jongmal/picanvas/docs/bom/edp-board.png

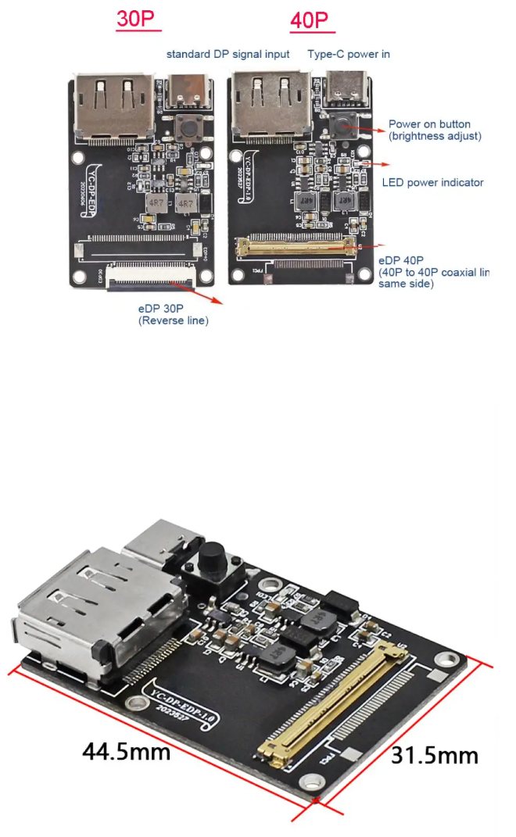
docs/bom/edp-board.png
