jongmal/picanvas/docs/bom/스태퍼모터보드.png

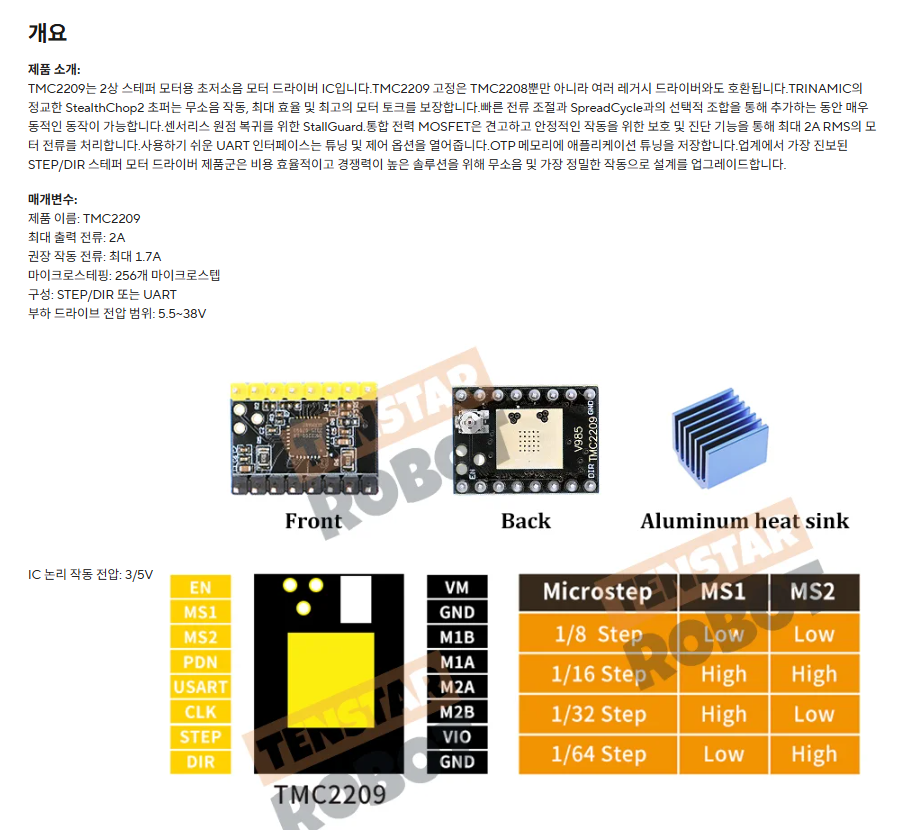
docs/bom/스태퍼모터보드.png
