jongmal/picanvas/docs/진행상황.md

# PiCanvas - 프로젝트 컨텍스트

## 프로젝트 개요
15.6인치 IPS 디스플레이를 사용하는 **벽걸이 회전형 디지털 액자**.
Raspberry Pi 4B 기반으로 가로/세로 90° 자동 회전, API 디지털액자 기능, SD카드 메타데이터 표시 예정.

## 현재 진행 상태 (2026-04-02)

### 완료
- [x] 설계 명세서 작성 (`SPEC.md`)
- [x] 모델 A - 중앙 브라켓 + GT2 80T 풀리 (`src/model_a_center_bracket.scad`)
- [x] 모델 A - 십자 보강재 (`src/model_a_cross_brace.scad`)
- [x] 모델 A - 액자 프레임 6분할 + 도브테일 (`src/model_a_frame.scad`)
- [x] 모델 B - 벽면 브라켓 + 모터 마운트 (`src/model_b_wall_bracket.scad`)
- [x] 전체 어셈블리 (`src/assembly.scad`)
- [x] 플레이트 12개 분리 (`plates/`)
- [x] 180mm 배드 크기 검증 (모두 통과)

### 미완료
- [ ] 부품 마운트 상세 (Pi 4B, eDP 보드, TMC2209, 스텝다운, 디코이, 콘덴서, 퓨즈)
- [ ] LCD 후면 클립 (코드는 있으나 프레임에 미배치)
- [ ] 프레임↔십자 보강재 도브테일 끼워맞춤 검증
- [ ] 벨트 경로 간섭 확인
- [ ] C타입 케이블 진입부 (프레임 하단) 모델링
- [ ] STL 출력 및 실물 테스트핏
- [ ] 소프트웨어 (API 액자, SD 메타데이터 표시)

## 핵심 설계 결정

### 1. Z축 적층 구조 (벽면 → 전면)
```
벽면 → 모델B(5mm) → 턴테이블 고정판(10.5mm) → 회전판 → 모델A 중앙브라켓(5mm) + 80T풀리(8mm) → 십자 보강 → 부품 → LCD(3.2mm) → 베젤 립(3mm)
```
- 턴테이블과 풀리가 같은 평면에서 겹치는 문제 → **Z축 오프셋으로 해결**
- 턴테이블이 하중 담당, 풀리가 회전력 전달

### 2. 프레임 분할
- 원래 4분할 → 가로 181.33mm로 180mm 초과
- **6분할(3x2)로 변경** → 각 세그먼트 120.89 x 114.13mm
- 각 분할선에 도브테일 조인트

### 3. 80T 풀리 일체형
- GT2 80T 외치 풀리가 중앙 브라켓에 일체 성형
- 축 없이 턴테이블 회전판에 직접 체결
- 피치 직경 ~50.93mm, 벨트 폭 6mm + 상하 가이드 플랜지

### 4. 벨트 300mm 폐루프
- 축간 거리 ~98mm (20T↔80T)
- 감속비 4:1, 유효 토크 ~48 N·cm

### 5. 모터 배치
- 17HS4023 팬케이크 모터, 축 수직 (샤프트 위 방향)
- 모델 B에서 측면 클램프로 고정
- 높이 최소화 목적

## 파일 구조
```
picanvas/
├── SPEC.md                    # 설계 명세서 (부품 스펙, 배선도, 회전 메커니즘)
├── docs/
│   ├── CONTEXT.md             # 이 파일 (프로젝트 컨텍스트)
│   ├── bom/                   # 부품 참고 이미지
│   └── modeling/              # 모델링 참고 이미지
├── src/                       # 소스 모델
│   ├── assembly.scad          # 전체 어셈블리 (디버그 뷰)
│   ├── model_a_center_bracket.scad
│   ├── model_a_cross_brace.scad
│   ├── model_a_frame.scad
│   └── model_b_wall_bracket.scad
├── plates/                    # 개별 출력용 (A1 Mini 180mm)
│   ├── plate_1  ~ plate_5     # 중앙 브라켓 + 십자 보강재
│   ├── plate_6  ~ plate_11    # 프레임 6분할
│   └── plate_12               # 모델 B 벽면 브라켓
└── preview/                   # 렌더링 미리보기 PNG
```

## 주요 파라미터 (공통값)
| 파라미터 | 값 | 사용처 |
|---|-----|---|
| lcd_w / lcd_h / lcd_d | 350.66 / 216.25 / 3.2 mm | 전체 |
| frame_wall | 6 mm | 프레임 벽 두께 |
| frame_bezel | 3 mm | 전면 오버랩 |
| bracket_size | 70 mm | 중앙 브라켓 한 변 |
| bracket_thickness | 5 mm | 브라켓/보강재 두께 |
| dt_width / dt_depth | 15 / 8 mm | 도브테일 (브라켓↔보강재) |
| sdt_width / sdt_depth | 10 / 4 mm | 도브테일 (프레임 세그먼트간) |
| tb_size | 57 mm | 턴테이블 베어링 |
| belt_center_distance | 98 mm | 풀리 축간 거리 |

## 배선 요약
```
65W USB-C → PD 디코이(12V) → A: 5V스텝다운→Pi / B: 12V→TMC2209→모터 / C: 12V→eDP보드
Pi GPIO → TMC2209(STEP/DIR) → 모터
Pi micro HDMI → eDP 컨트롤러 → eDP 40pin → 15.6" IPS
```

## OpenSCAD CLI 참고
```bash
# 프리뷰 렌더링
"/c/Program Files/OpenSCAD/openscad.com" -o output.png --imgsize=800,600 --camera=0,0,10,55,0,25,180 input.scad

# STL 출력
"/c/Program Files/OpenSCAD/openscad.com" -o output.stl input.scad
```

## 다음 작업 우선순위
1. 부품 마운트 상세 설계 (Pi, 보드류 고정 방식)
2. LCD 클립 프레임 배치
3. 케이블 진입부 모델링
4. STL 출력 → 테스트핏
5. 소프트웨어 개발 (별도 레포 또는 서브폴더)
