jongmal/picanvas/docs/modeling/openscad_by_claude2.png

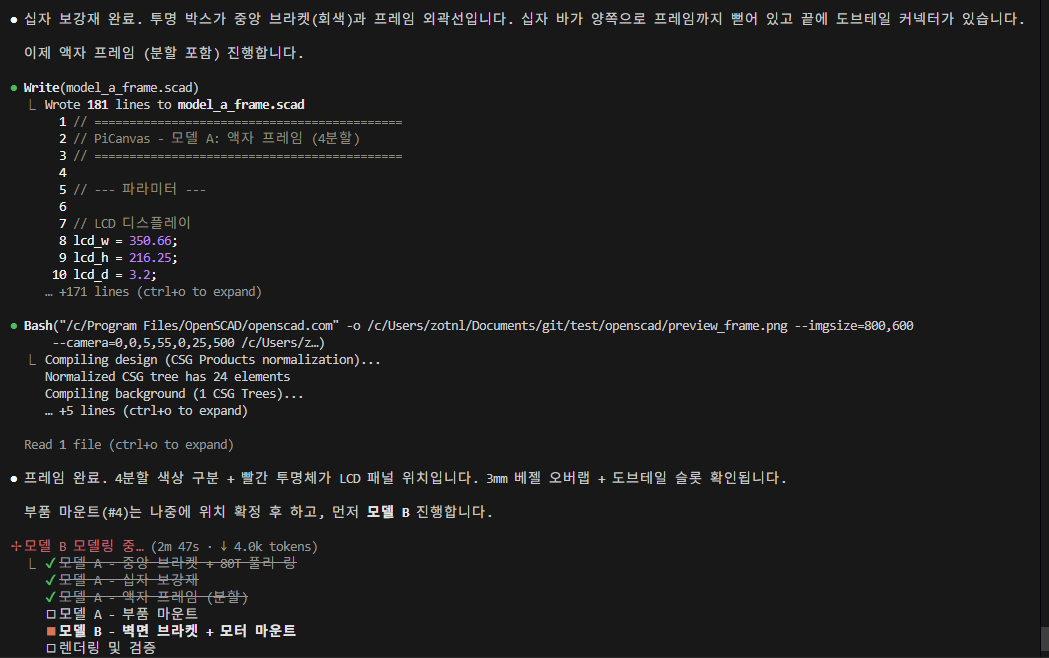
docs/modeling/openscad_by_claude2.png
