jongmal/picanvas/docs/modeling/openscad_by_claude.png

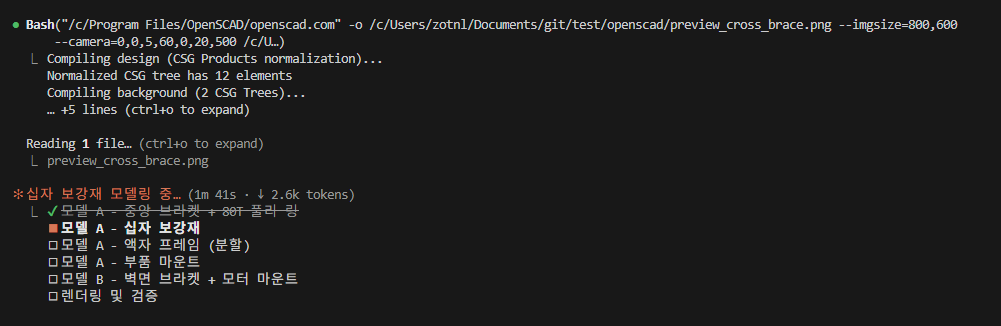
docs/modeling/openscad_by_claude.png
