jongmal/picanvas/preview/preview_center_bracket.png

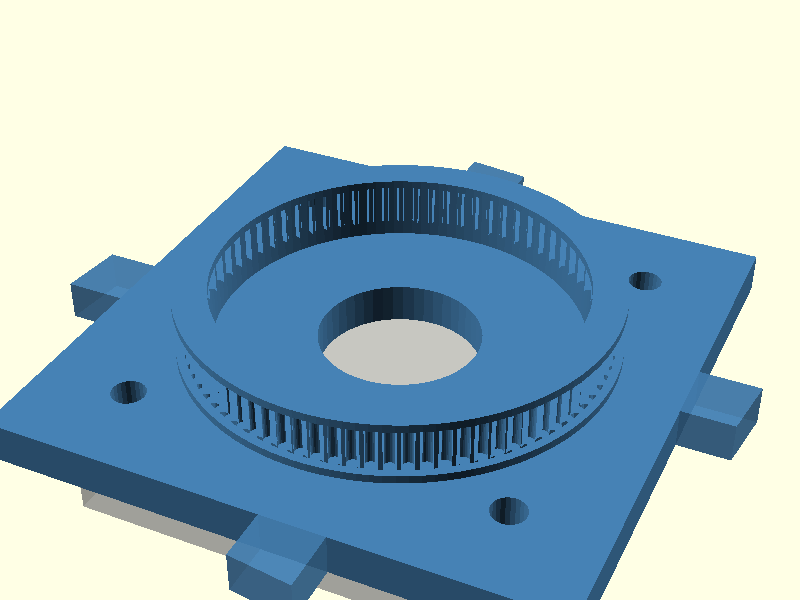
preview/preview_center_bracket.png
