jongmal/picanvas/preview/preview_cross_brace.png

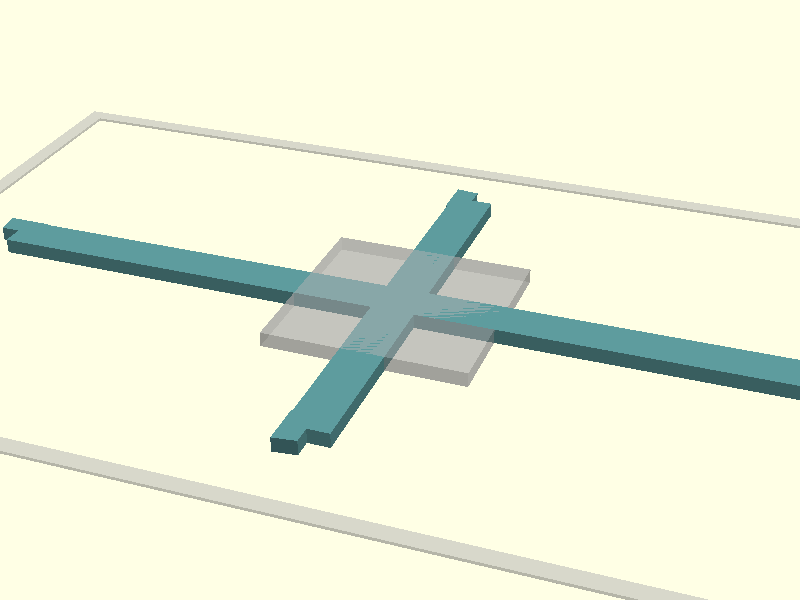
preview/preview_cross_brace.png
