jongmal/picanvas/preview/preview_frame.png

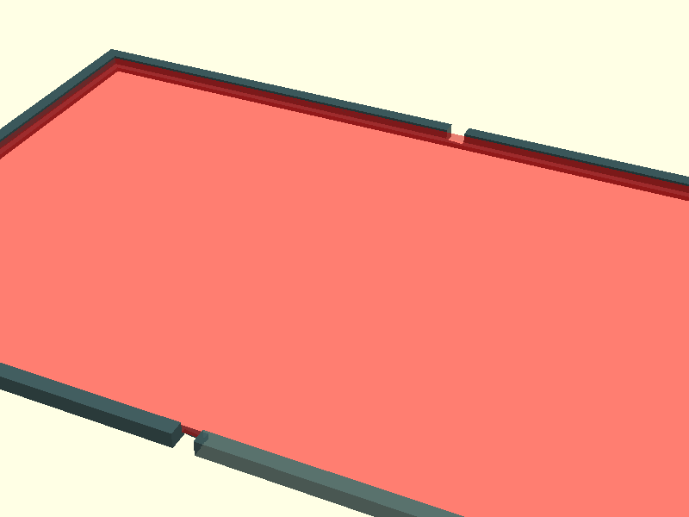
preview/preview_frame.png
