jongmal/picanvas/preview/preview_model_b.png

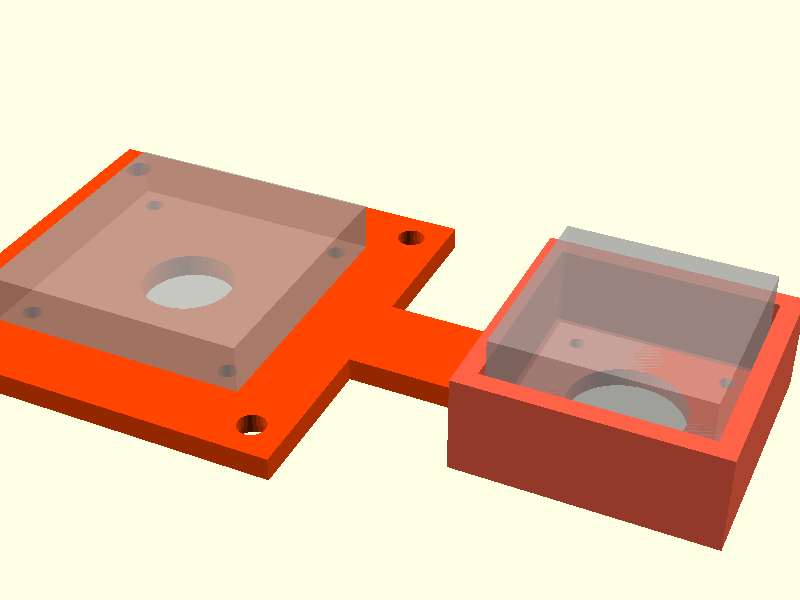
preview/preview_model_b.png
