jongmal/picanvas/docs/bom/1.png

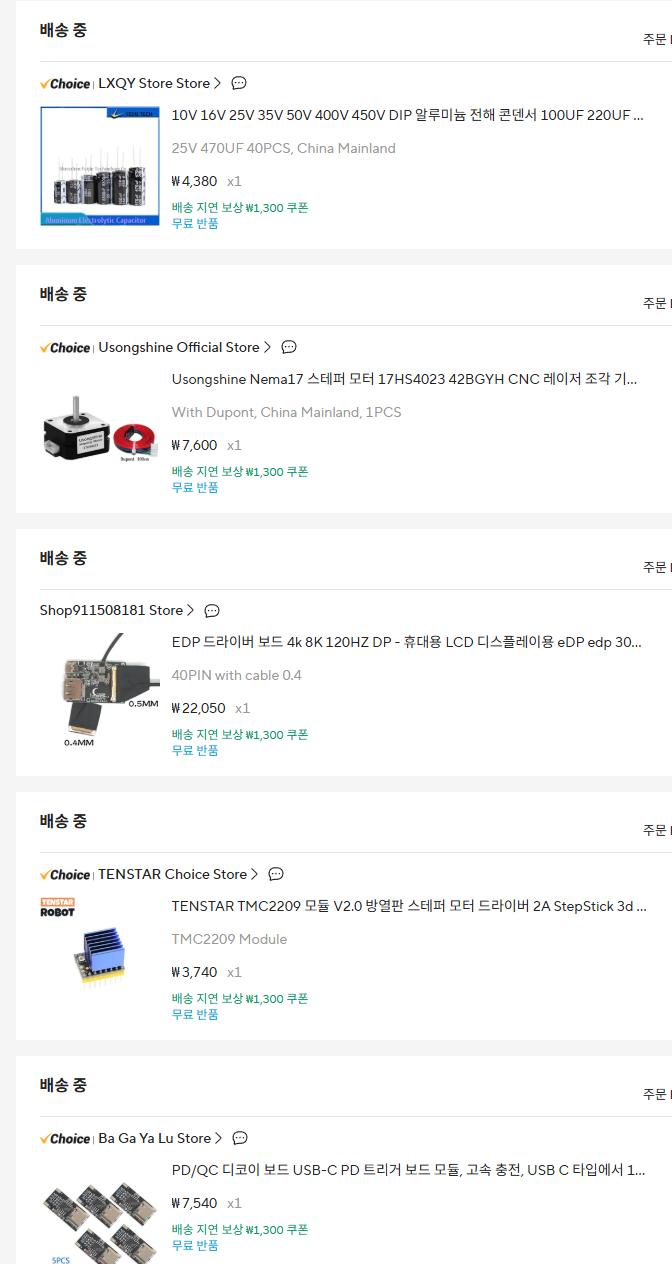
docs/bom/1.png
