jongmal/picanvas/docs/bom/2.png

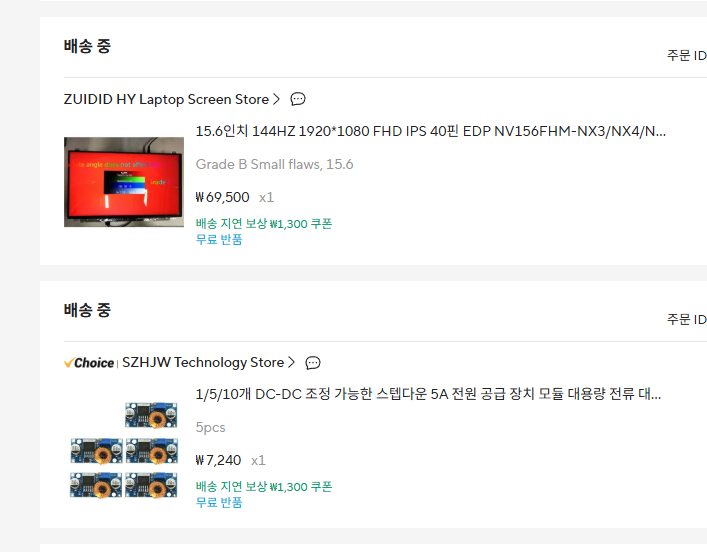
docs/bom/2.png
