jongmal/picanvas/plates/plate_10_frame_BC.scad

// ============================================
// Plate 10: 프레임 - 하단 중앙 (BC)
// 크기: ~121 x ~114 mm (OK)
// ============================================
use <../src/model_a_frame.scad>

frame_seg_BC();
