jongmal/picanvas/plates/plate_11_frame_BR.scad

// ============================================
// Plate 11: 프레임 - 하단 우 (BR)
// 크기: ~121 x ~114 mm (OK)
// ============================================
use <../src/model_a_frame.scad>

frame_seg_BR();
