jongmal/picanvas/plates/plate_12_wall_bracket.scad

// ============================================
// Plate 12: 모델 B - 벽면 브라켓 + 모터 마운트
// 크기: ~168 x 87 mm (OK)
// ============================================
use <../src/model_b_wall_bracket.scad>

model_b_wall_bracket();
