jongmal/picanvas/plates/plate_1_center_bracket.scad

// ============================================
// Plate 1: 중앙 브라켓 + GT2 80T 풀리
// 크기: 70 x 70 mm (OK)
// ============================================
use <../src/model_a_center_bracket.scad>

model_a_center_bracket();
