jongmal/picanvas/plates/plate_6_frame_TL.scad

// ============================================
// Plate 6: 프레임 - 상단 좌 (TL)
// 크기: ~121 x ~114 mm (OK)
// ============================================
use <../src/model_a_frame.scad>

frame_seg_TL();
