jongmal/picanvas/plates/plate_7_frame_TC.scad

// ============================================
// Plate 7: 프레임 - 상단 중앙 (TC)
// 크기: ~121 x ~114 mm (OK)
// ============================================
use <../src/model_a_frame.scad>

frame_seg_TC();
