jongmal/picanvas/plates/plate_8_frame_TR.scad

// ============================================
// Plate 8: 프레임 - 상단 우 (TR)
// 크기: ~121 x ~114 mm (OK)
// ============================================
use <../src/model_a_frame.scad>

frame_seg_TR();
