jongmal/picanvas/plates/plate_9_frame_BL.scad

// ============================================
// Plate 9: 프레임 - 하단 좌 (BL)
// 크기: ~121 x ~114 mm (OK)
// ============================================
use <../src/model_a_frame.scad>

frame_seg_BL();
