jongmal/picanvas/(list of files, cad)

Other CAD files:
plates/plate_5_cross_v_bottom.scad
