jongmal/picanvas/preview/preview_assembly.png

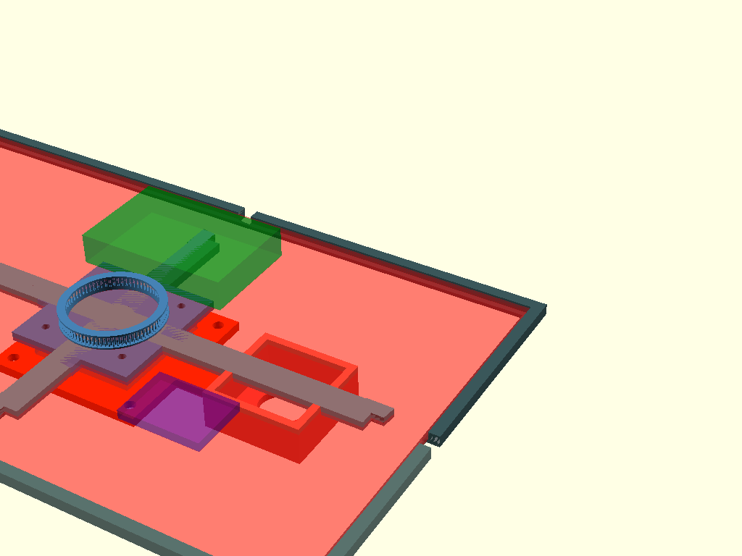
preview/preview_assembly.png
