jongmal/picanvas/test_print.jpg

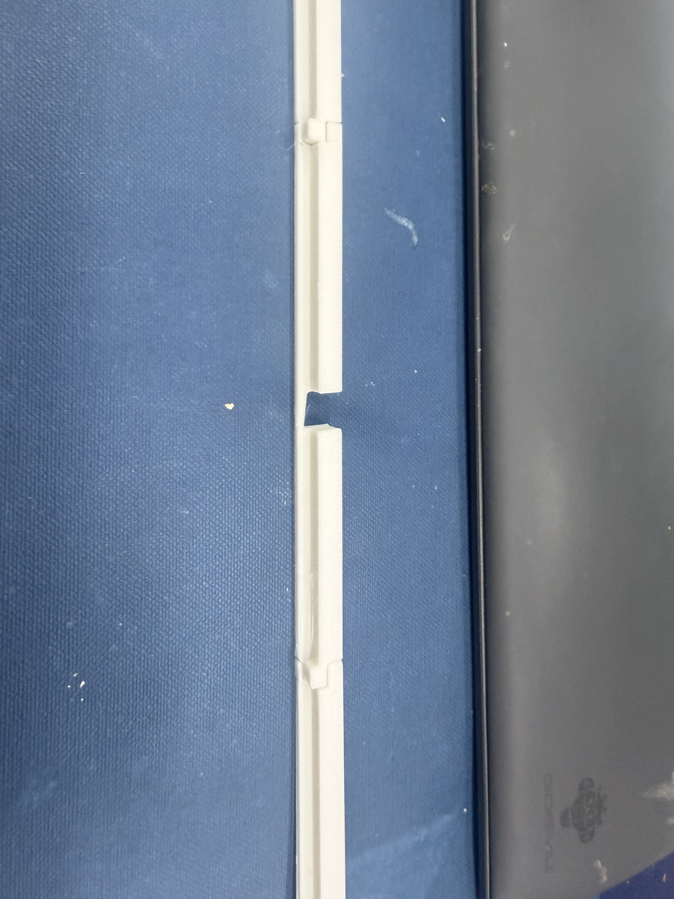
test_print.jpg
