jongmal/picanvas/test1.png

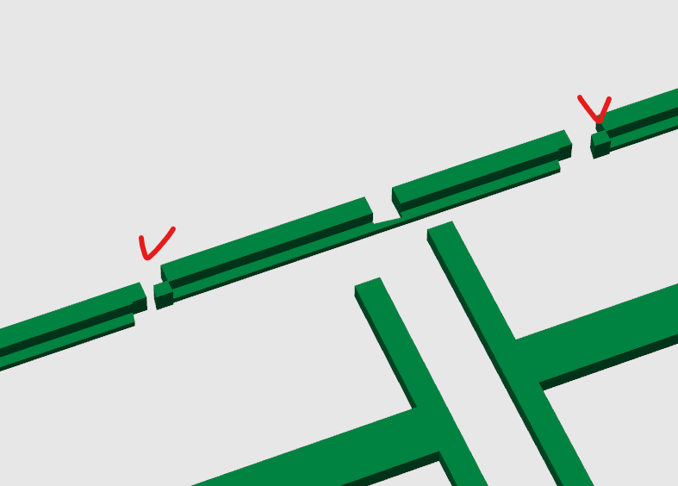
test1.png
