jongmal/picanvas/test2.png

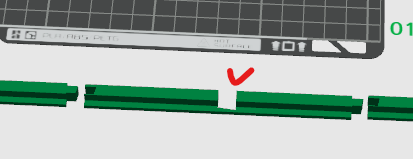
test2.png
