jongmal/picanvas/(commit log)

2026-04-02 init: picanvas 프로젝트 초기화
    - 설계 명세서 (SPEC.md)
    - 참고 이미지 (eDP 보드, 스테퍼 드라이버)
    - .gitignore
2026-04-02 feat: 3D 모델링 초안 + 플레이트 분할 + 프로젝트 구조 정리
    - 모델 A: 중앙 브라켓(80T 풀리 일체형), 십자 보강재, 프레임 6분할
    - 모델 B: 벽면 브라켓 + NEMA17 모터 마운트
    - 전체 어셈블리 뷰 (assembly.scad)
    - A1 Mini 180mm 배드용 12개 플레이트 분리 (plates/)
    - 폴더 구조 정리 (src/, plates/, preview/, docs/)
    - 프로젝트 컨텍스트 문서 작성
    [assembly.scad, model_a_center_bracket.scad, model_a_cross_brace.scad, model_a_frame.scad, model_b_wall_bracket.scad, plate_10_frame_BC.scad, plate_11_frame_BR.scad, plate_12_wall_bracket.scad]
2026-04-03 fix: 도브테일 LCD 간섭 수정 + 클리어런스 조정
    - 세그먼트간 도브테일 위치를 프레임 바깥쪽 가장자리로 이동 (LCD 간섭 제거)
    - 도브테일 클리어런스 0.15 → 0.08mm (가결합 가능하도록)
    - 소스 파일 최상위 호출 제거 (plate별 STL 내보내기 정상화)
    [model_a_center_bracket.scad, model_a_cross_brace.scad, model_a_frame.scad, model_b_wall_bracket.scad]
2026-04-03 fix: 도브테일/보강재/어셈블리 전면 수정
    - 세그먼트 도브테일 폭 10→5mm (벽 두께 6mm 내 수용)
    - 보강재 슬롯 깊이 8→5mm (프레임 벽 관통 방지)
    - 보강재 바 길이를 프레임 내벽까지로 조정
    - 어셈블리 Z축 재배치 (전면=Z0, 벽면=Z+)
    - 풀리/부품이 LCD 뒤쪽(벽쪽)에 정확히 위치하도록 수정
    [assembly.scad, model_a_center_bracket.scad, model_a_cross_brace.scad, model_a_frame.scad]
2026-04-03 fix: 모델B 모터 클램프 방향 수정
    - 모터 클램프/브릿지를 -Z(프레임쪽)로 돌출하도록 변경
    - 벽면 플레이트는 +Z(벽쪽) 유지
    - 모터 샤프트가 프레임쪽 풀리/벨트와 정렬
    [model_b_wall_bracket.scad]
